andrei-s21/Keyless_Entry/Protocol data/Untitled Diagram.drawio.png

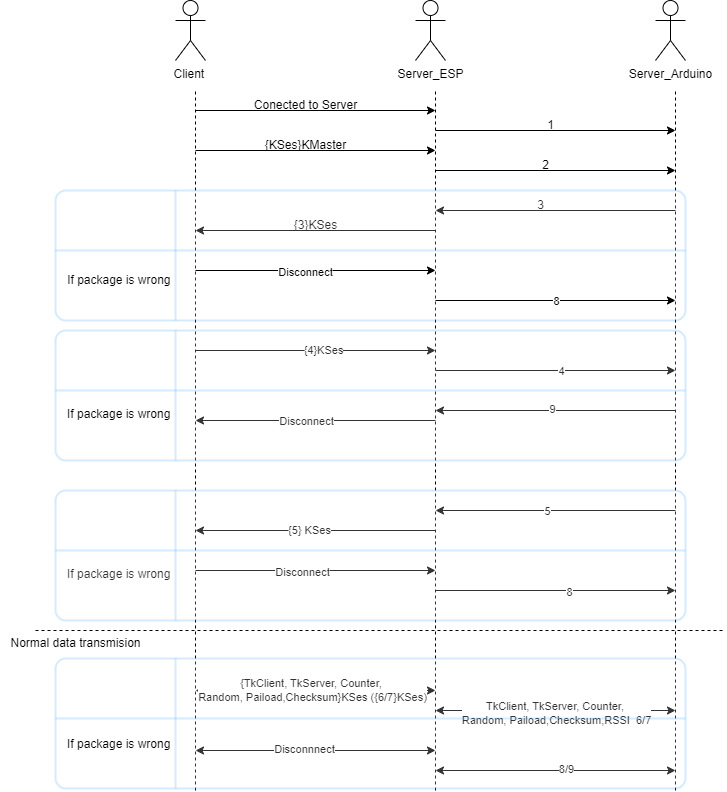
Protocol data/Untitled Diagram.drawio.png
