andrei-s21/Keyless_Entry/Protocol data/Untitled(1).png

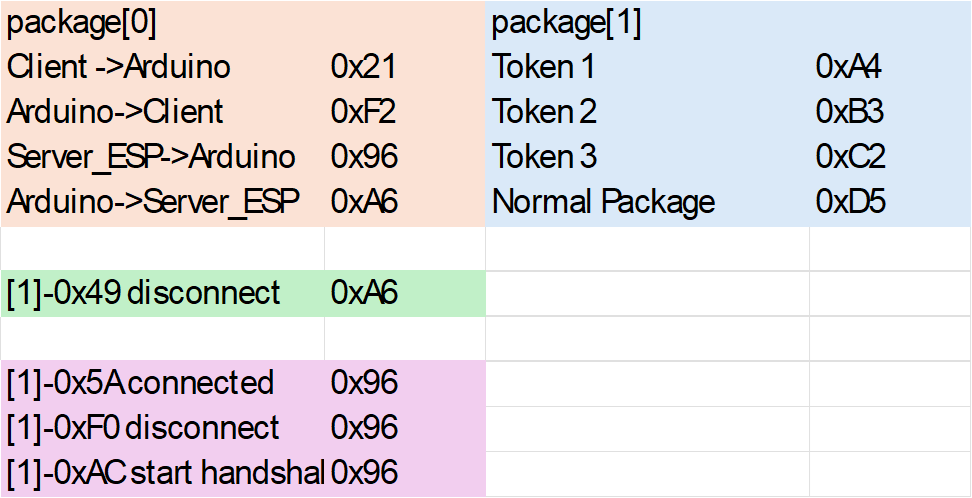
Protocol data/Untitled(1).png
