andrei-s21/Keyless_Entry/Protocol data/Untitled.png

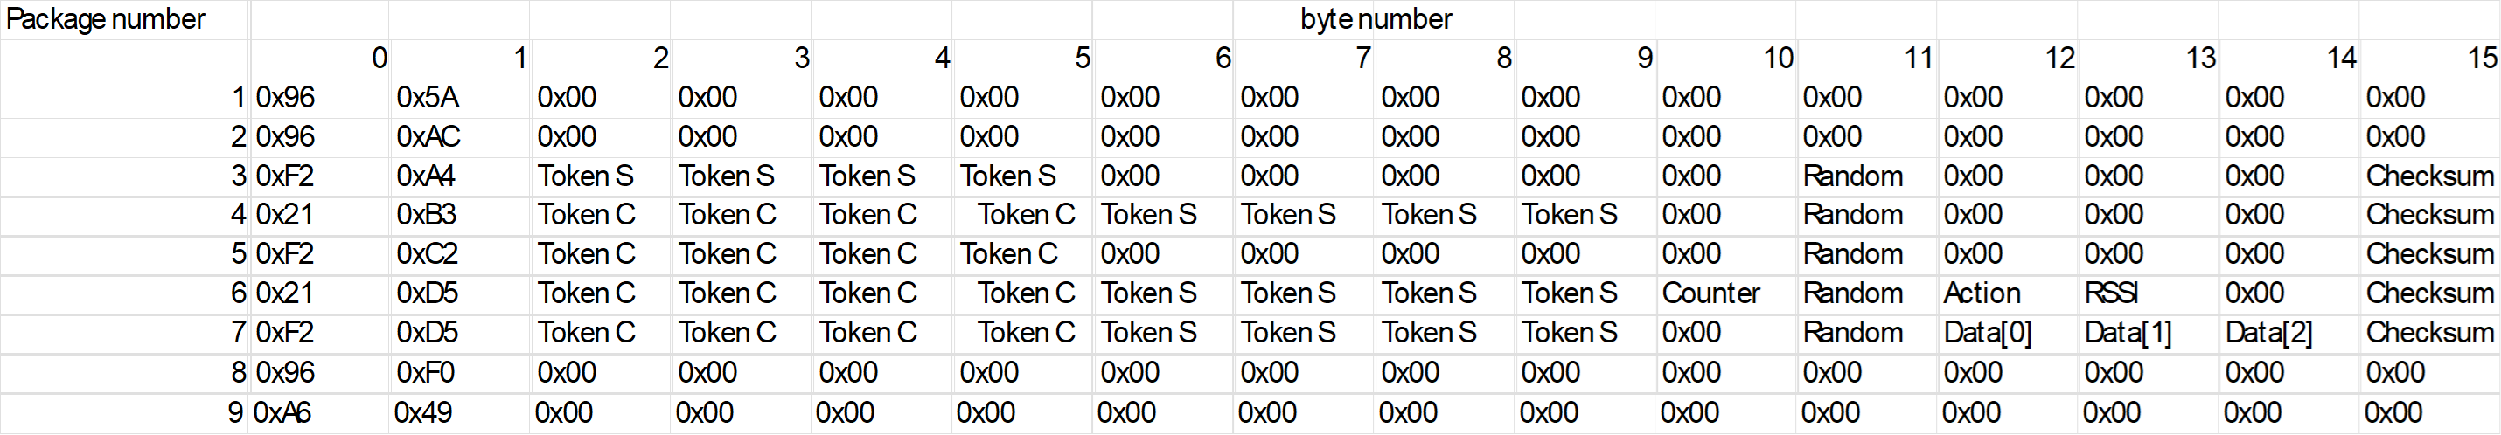
Protocol data/Untitled.png
