andrei-s21/Keyless_Entry/(list of files, drawings)

Other design files:
EasyEDA/keyless entry car/PCB_keyless entry car.json
EasyEDA/keyless key/PCB_keyless key.json
